JosiahMendes/Autonomous-Rover/Vision/readme.md

## Organisation of Files

Folder DE10_LITE_D8M_VIP_16 contains the Quartus Project together with the software that runs on the Nios II Processor. To test the project, open this folder and and open the `.qpf` file.  

`Distance Calc.C` and `DistanceCalcCalibration.m ` show the implementation of the object location calculation algorithm.

`Testbenches` contain Testbenches for some of the individual modules used in the design of the Image Processing Module

`UART` and `SPI Example Comms` Contain attempts and testing files used for implementing communications between the image processor and the ESP32.
