JosiahMendes/Autonomous-Rover/Energy/README.txt

Note for instructor:
-The folder "PV_power_charger" contains the charging algorithm.
-The folder "discharge_algorithm" contains the algorithm used when discharging the battery
-CSV files of charge cycles are found in the "CSV-files" folder
