JosiahMendes/Autonomous-Rover/Driving/Driving_Structure/Driving subpart.docx

Driving subpart

- Input voltage: ≈5V
- Maximum Input Current: ≈0.245A
- Minimum output voltage: 1.384V
- Maximum output voltage: 4.82V
- Minimum Period: 0.941s
- Maximum RPM: 63.7619

Speed Level | RPM | km/h | mph | Voltage(v)
Very fast | 63.76 | 0.8173 | 0.5078 | 4.82
Fast | 51.77 | 0.6636 | 0.4123 | 3.98
Regular | 39.84 | 0.5107 | 0.3173 | 3.14
Slow | 28.30 | 0.3628 | 0.2254 | 2.3
Very Slow | 19.69 | 0.2524 | 0.1568 | 1.46

The relationship between the voltage and the RPM is almost linear.

These 5 levels of moving speed are the options for the user to send, us a command to the rover. They have been made like that in order, to be, as much simplified and user friendly. Additionally, it is more convenient and straightforward as it does not require further knowledge from the user (voltages, RPM).

On the other hand, someone has the option to give as an input a voltage (1.4V-4.82V) or RPM (20-63.76).
