JosiahMendes/Autonomous-Rover/Energy/Figures/1-s2.0-S0038092X16300111-gr12_lrg.jpg

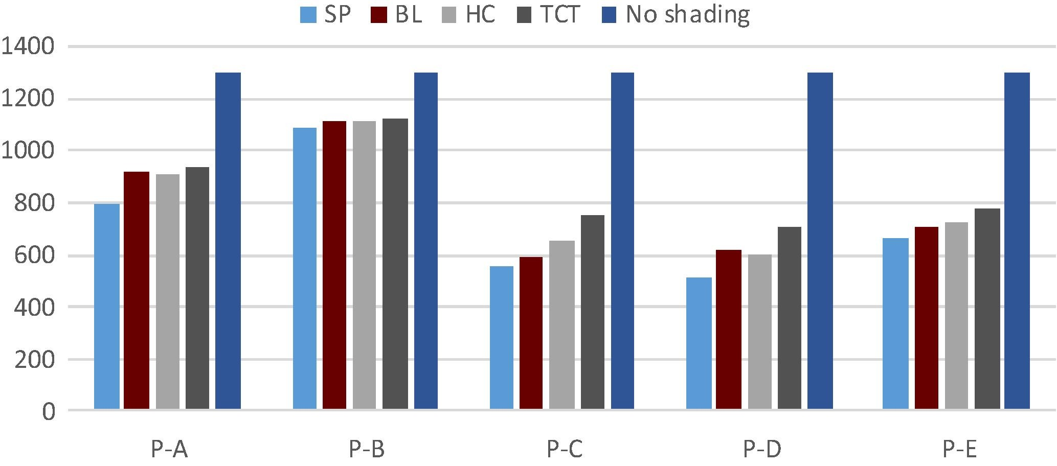
Energy/Figures/1-s2.0-S0038092X16300111-gr12_lrg.jpg
