JosiahMendes/Autonomous-Rover/Energy/Figures/Boost_efficiency.png

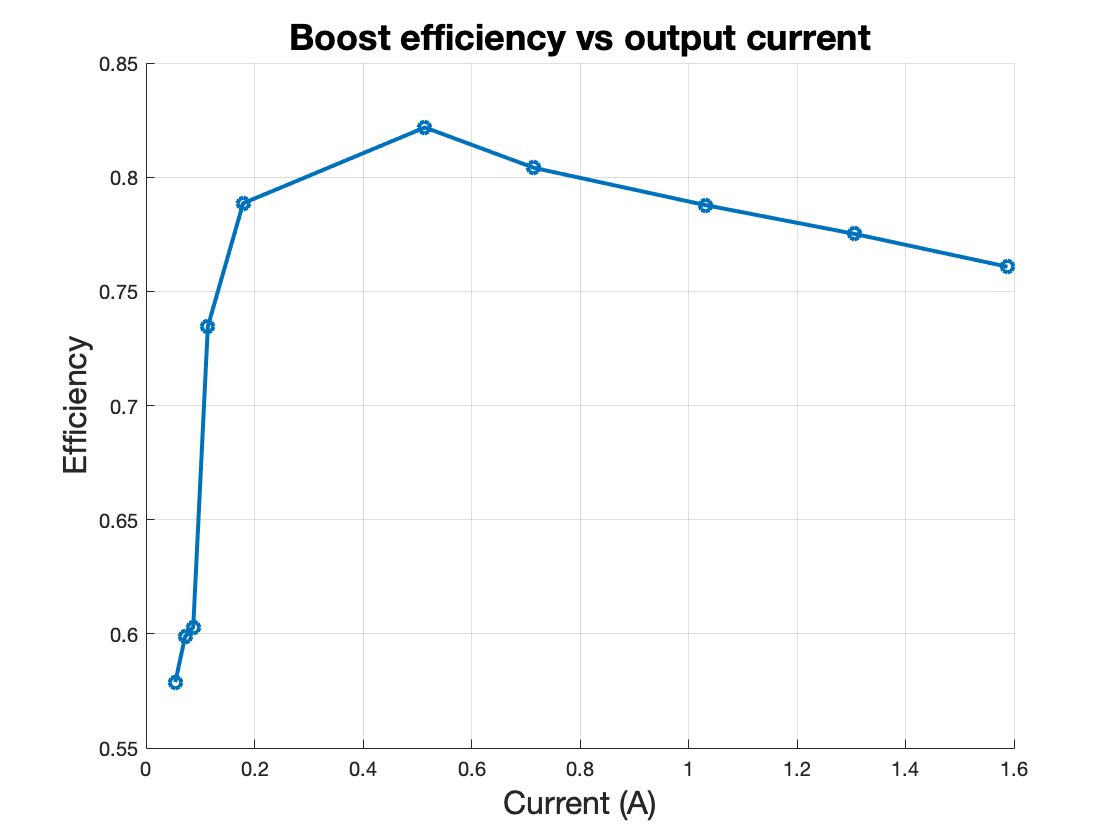
Energy/Figures/Boost_efficiency.png
