JosiahMendes/Autonomous-Rover/Energy/Figures/Circuit_Diagram.png

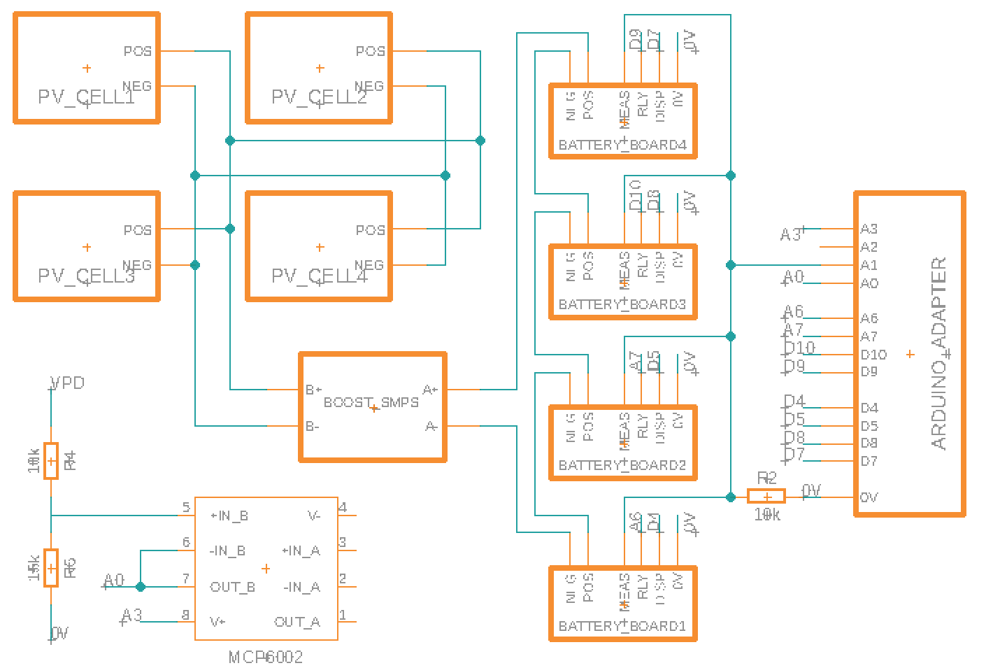
Energy/Figures/Circuit_Diagram.png
