JosiahMendes/Autonomous-Rover/Energy/Skjermbilde 2021-05-26 kl. 19.03.05 1.png

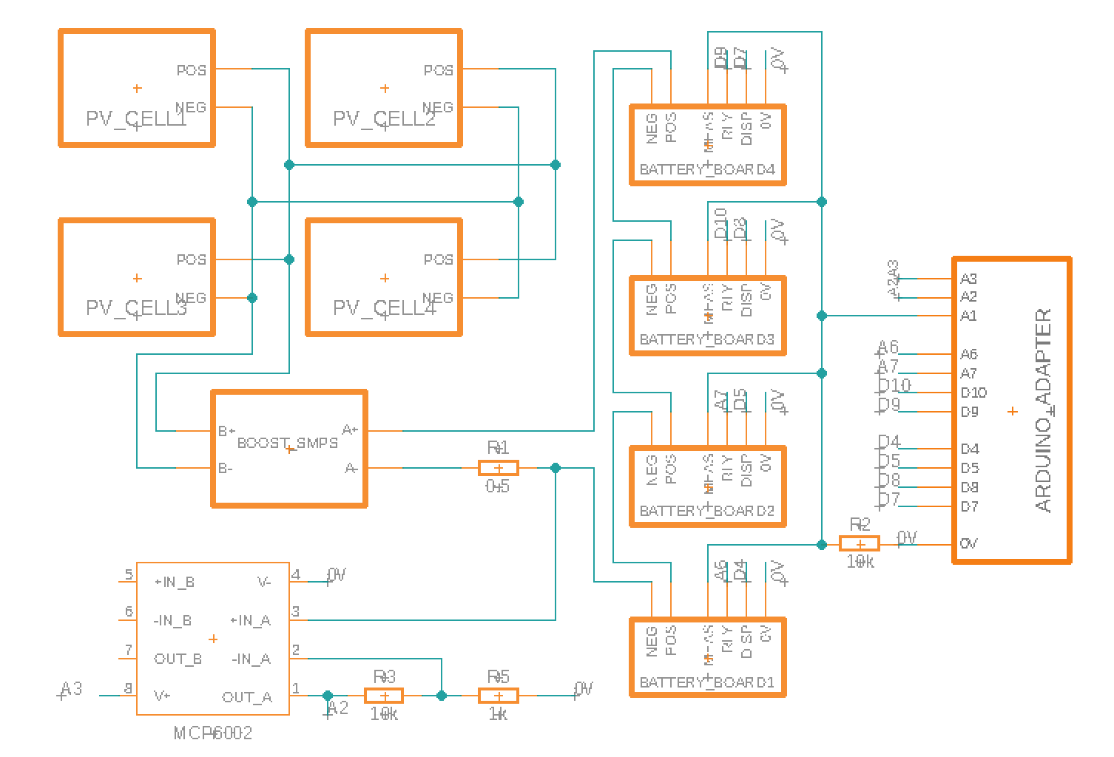
Energy/Skjermbilde 2021-05-26 kl. 19.03.05 1.png
