JosiahMendes/Autonomous-Rover/report/images/ControlFR.png

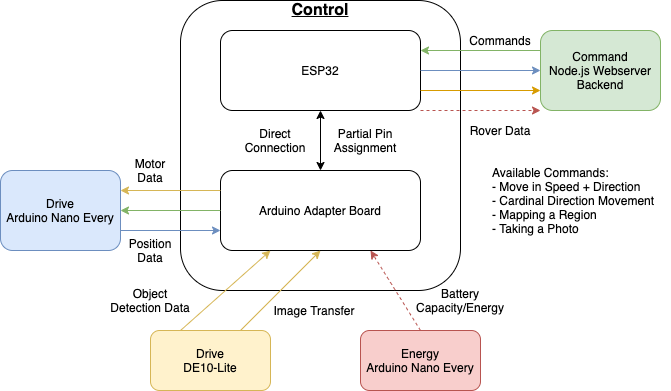
report/images/ControlFR.png
