JosiahMendes/Autonomous-Rover/Integration/TestImages/full_ball_63cm.jpg

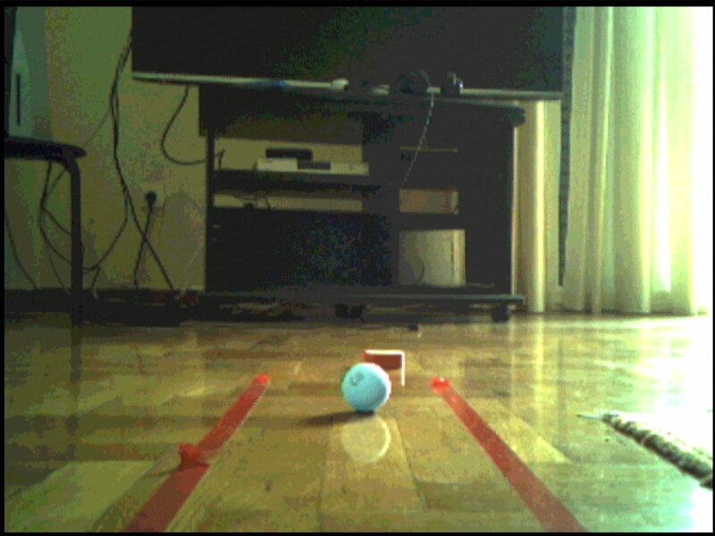
Integration/TestImages/full_ball_63cm.jpg
