JosiahMendes/Autonomous-Rover/report/media/ImageProcessingStream.pdf

### FPGA Device

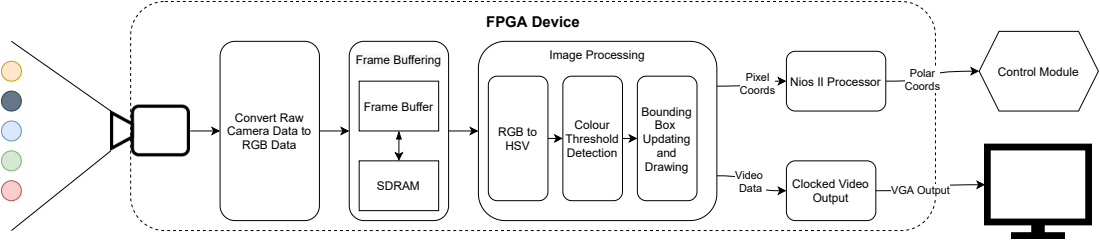
[picture p65: page 1]
Video Data; Pixel Coords; Image Processing; RGB to HSV; Frame Buffering; SDRAM; Frame Buffer; Colour Threshold Detection; Bounding Box Updating and Drawing; Polar; Nios II Processor; Coords; Control Module

Convert Raw
Camera Data to
RGB Data

VGA Output Clocked Video
Output
