JosiahMendes/Autonomous-Rover/report/media/SPI_ImageTransfer.pdf

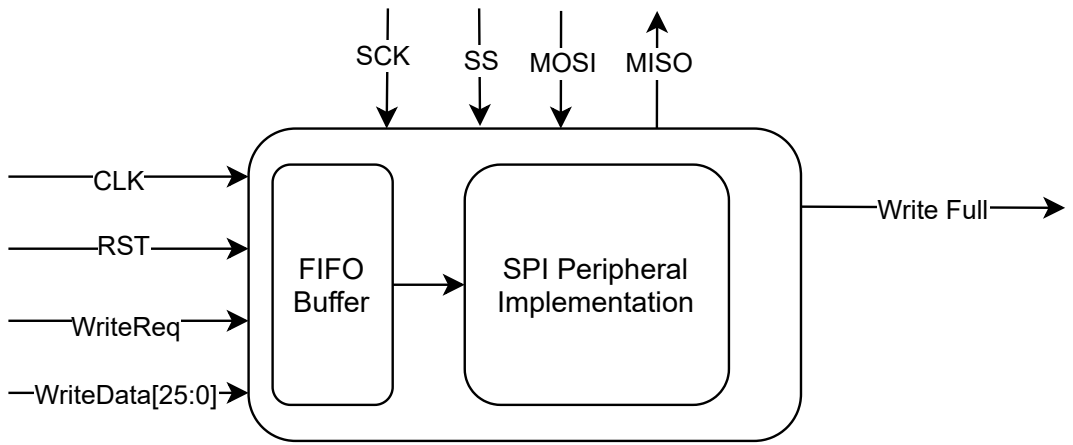
[picture p66: page 1]
CLK; WriteReq; RST; WriteData[25:0]; SCK; MOSI; MISO; Write Full; FIFO Buffer; SPI Peripheral Implementation
