JosiahMendes/Autonomous-Rover/report/media/ControlFunctional.pdf

## Control

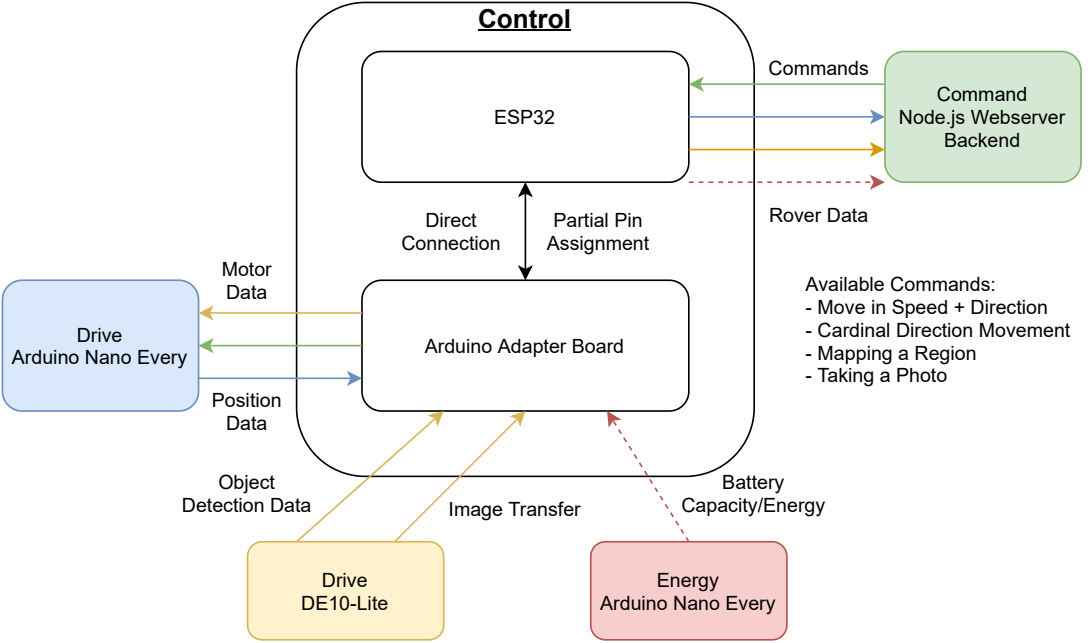
[picture p67: page 1]
ESP32; Partial Pin Assignment; Direct Connection; Object Detection Data; Drive DE10-Lite; Drive; Battery Capacity/Energy; Commands; Motor Data; Position Data; Rover Data; Image Transfer

Command
Node.js Webserver
Backend

Available Commands:
- Move in Speed + Direction
- Cardinal Direction Movement
- Mapping a Region
- Taking a Photo

Arduino Adapter Board

Arduino Nano Every

Energy
