JosiahMendes/Autonomous-Rover/report/media/StructuralDiagram.pdf

Vision | Energy

# MARS Rover Structural Diagram

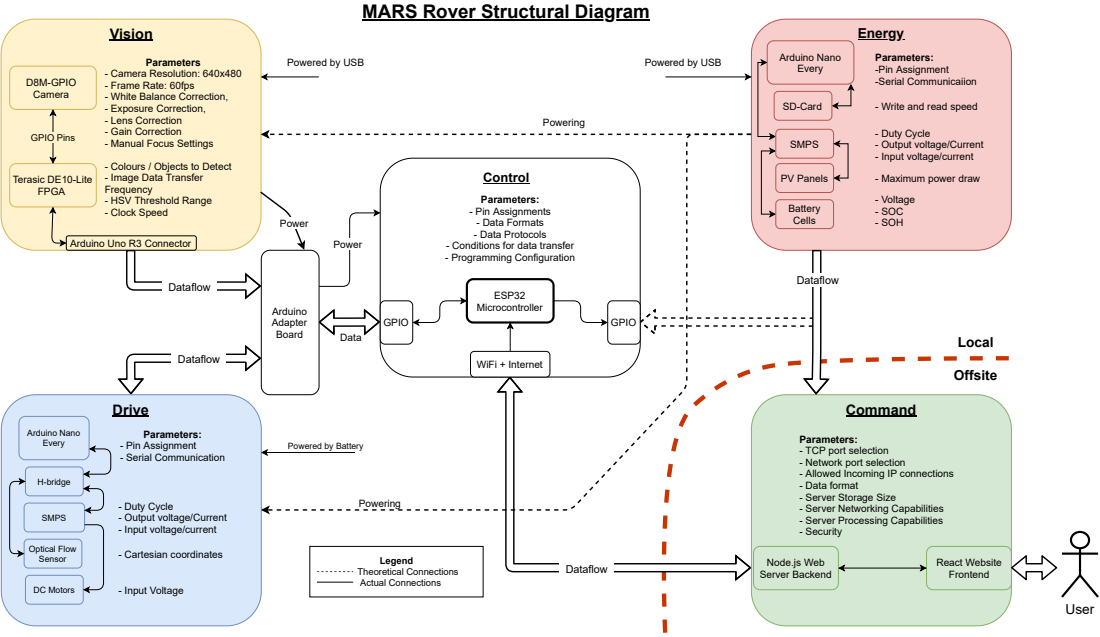
[picture p68: page 1]
ESP32 Microcontroller; Power; Arduino Adapter Board; Arduino Nano Every; SMPS; Battery Cells; PV Panels; D8M-GPIO Camera; Terasic DE10-Lite FPGA; Control; SD-Card; Powering; Powered by USB; GPIO Pins; Dataflow; Parameters: -Pin Assignment -Serial Communicaiion; Parameters; Legend Theoretical Connections Actual Connections; Optical Flow Sensor; DC Motors; Drive; Parameters: - Pin Assignment - Serial Communication; - Cartesian coordinates; - Input Voltage; H-bridge; GPIO; WiFi + Internet; Data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

- Camera Resolution: 640x480
- Frame Rate: 60fps
- White Balance Correction,
- Exposure Correction,
- Lens Correction
- Gain Correction
- Manual Focus Settings

- Write and read speed

- Duty Cycle
- Output voltage/Current
- Input voltage/current

- Colours / Objects to Detect
- Image Data Transfer
Frequency
- HSV Threshold Range
- Clock Speed

- Maximum power draw
- Voltage
- SOC
- SOH

Parameters:
- Pin Assignments
- Data Formats
- Data Protocols
- Conditions for data transfer
- Programming Configuration

Arduino Uno R3 Connector

- TCP port selection
- Network port selection
- Allowed Incoming IP connections
- Data format
- Server Storage Size
- Server Networking Capabilities
- Server Processing Capabilities
- Security

Powered by Battery

Node.js Web
Server Backend
