JosiahMendes/Autonomous-Rover/report/media/ControlFlowChart.pdf

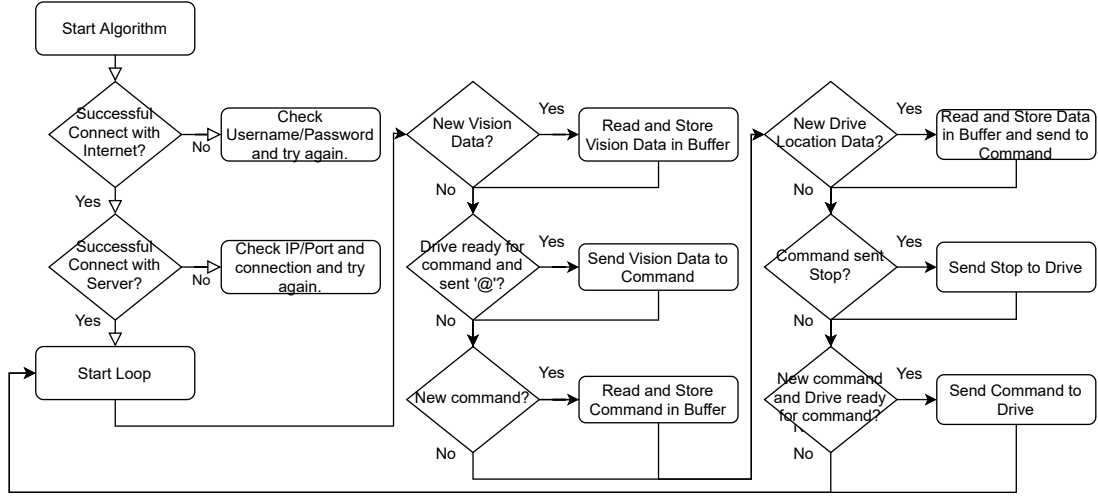
[picture p69: page 1]
Start Algorithm; Successful Connect with Internet?; Check Username/Password; Successful Connect with; Server?; Start Loop; New Vision Data?; New Drive Location Data?; Command sent Stop?; New command?; Yes; New command

Yes
Read and Store Data
in Buffer and send to
Command

Read and Store
Vision Data in Buffer

and try again.

Check IP/Port and
connection and try
again.

Drive ready for
command and
sent '@'?

Send Vision Data to

Send Stop to Drive

Command in Buffer

and Drive ready
for command?

Send Command to
Drive
