JosiahMendes/Autonomous-Rover/report/media/image3.pdf

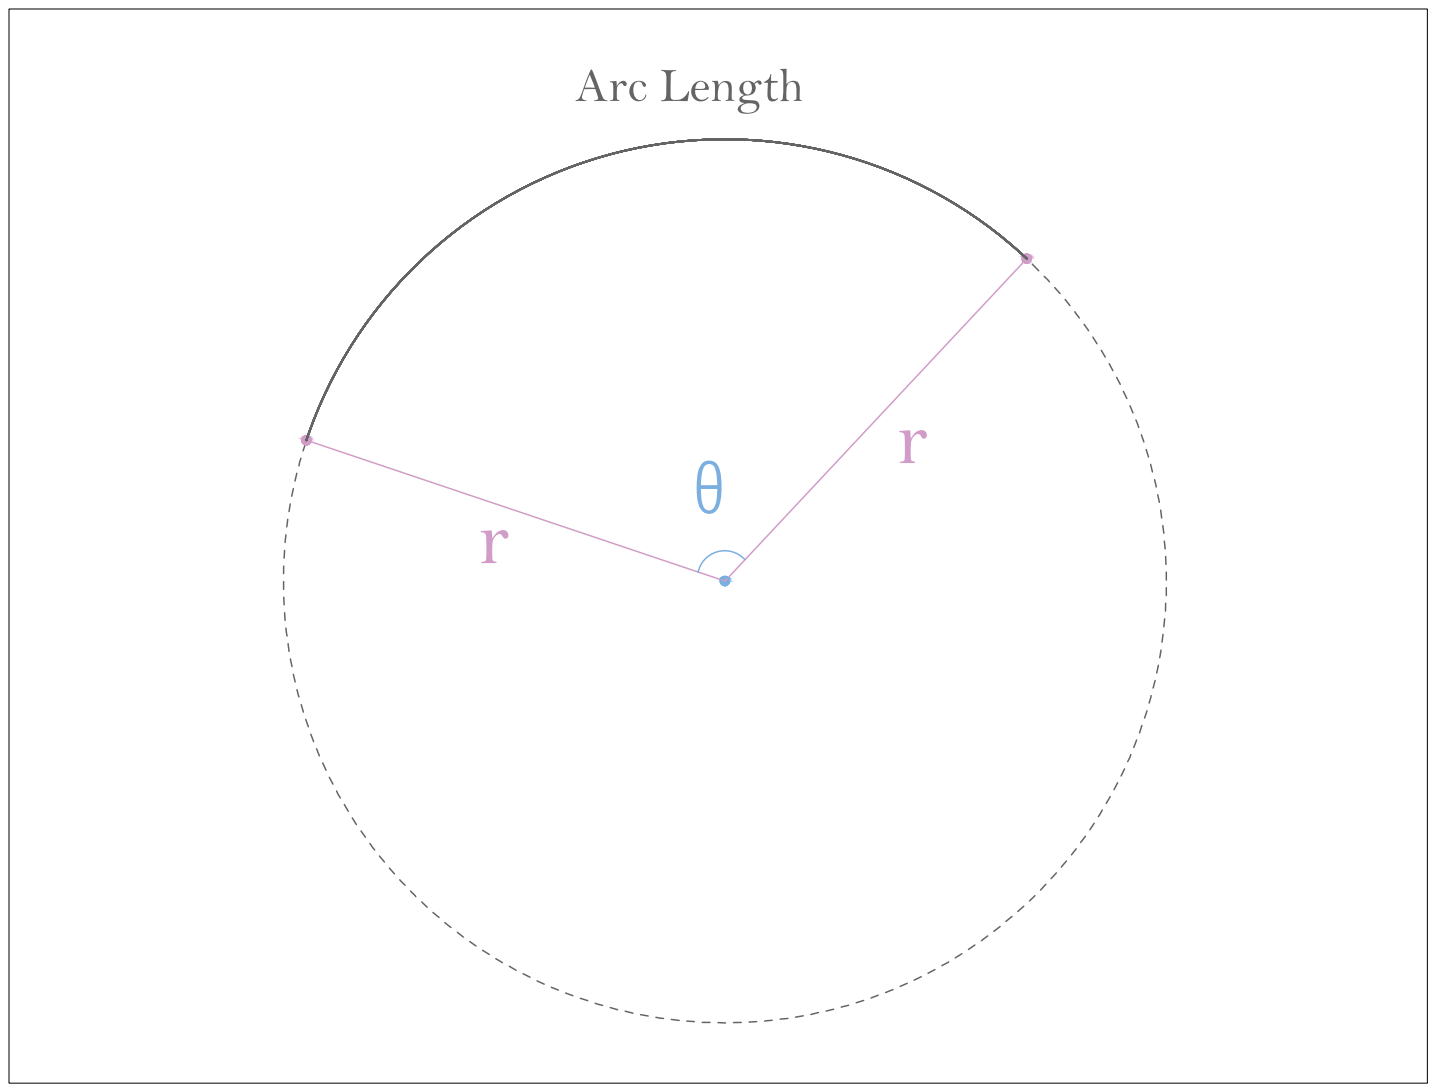
[picture p70: page 1]
