JosiahMendes/Autonomous-Rover/Energy/current_sensor/current_sensor.ino

/*
 * Program written by Yue Zhu (yue.zhu18@imperial.ac.uk) in July 2020.
 * pin6 is PWM output at 62.5kHz.
 * duty-cycle saturation is set as 2% - 98%
 * Control frequency is set as 1.25kHz. 
*/

//Include relevant libraries
#include <Wire.h>
#include <INA219_WE.h>
#include <SPI.h>
#include <SD.h>

INA219_WE ina219; // this is the instantiation of the library for the current sensor

// set up variables using the SD utility library functions:
Sd2Card card;
SdVolume volume;
SdFile root;

const int chipSelect = 10;
float open_loop = 0, closed_loop; // Duty Cycles
float vpd,vb,vref,iL,dutyref,current_mA; // Measurement Variables
unsigned int sensorValue0,sensorValue1,sensorValue2,sensorValue3;  // ADC sample values declaration
float ev=0,cv=0,ei=0,oc=0; //internal signals
float Ts=0.0008; //1.25 kHz control frequency. It's better to design the control period as integral multiple of switching period.
float kpv=0.05024,kiv=15.78,kdv=0; // voltage pid.
float u0v,u1v,delta_uv,e0v,e1v,e2v; // u->output; e->error; 0->this time; 1->last time; 2->last last time
float kpi=0.02512,kii=39.4,kdi=0; // current pid.
float u0i,u1i,delta_ui,e0i,e1i,e2i; // Internal values for the current controller
float uv_max=4, uv_min=0; //anti-windup limitation
float ui_max=1, ui_min=0; //anti-windup limitation
float current_limit = 1.0;
boolean Boost_mode = 0;
boolean CL_mode = 0;
float v05;
int int_count = 0;
String dataString;


unsigned int loopTrigger;
unsigned int com_count=0;   // a variables to count the interrupts. Used for program debugging.

void setup() {

  //5V supply for op-amp
  pinMode(17, OUTPUT);
  digitalWrite(17,true);
  
  
  //Basic pin setups
  noInterrupts(); //disable all interrupts
  pinMode(13, OUTPUT);  //Pin13 is used to time the loops of the controller
  pinMode(3, INPUT_PULLUP); //Pin3 is the input from the Buck/Boost switch
  pinMode(2, INPUT_PULLUP); // Pin 2 is the input from the CL/OL switch
  analogReference(EXTERNAL); // We are using an external analogue reference for the ADC

  // TimerA0 initialization for control-loop interrupt.
  
  TCA0.SINGLE.PER = 999; //
  TCA0.SINGLE.CMP1 = 999; //
  TCA0.SINGLE.CTRLA = TCA_SINGLE_CLKSEL_DIV16_gc | TCA_SINGLE_ENABLE_bm; //16 prescaler, 1M.
  TCA0.SINGLE.INTCTRL = TCA_SINGLE_CMP1_bm; 

  // TimerB0 initialization for PWM output
  
  pinMode(6, OUTPUT);
  TCB0.CTRLA=TCB_CLKSEL_CLKDIV1_gc | TCB_ENABLE_bm; //62.5kHz
  analogWrite(6,120); 

  


  interrupts();  //enable interrupts.
  Wire.begin(); // We need this for the i2c comms for the current sensor
  ina219.init(); // this initiates the current sensor
  Wire.setClock(700000); // set the comms speed for i2c
  Serial.begin(9600); // USB Communications


  
  //Check for the SD Card
  Serial.println("\nInitializing SD card...");
  if (!SD.begin(chipSelect)) {
    Serial.println("* is a card inserted?");
    while (true) {} //It will stick here FOREVER if no SD is in on boot
  } else {
    Serial.println("Wiring is correct and a card is present.");
  }

  if (SD.exists("CurrentS.csv")) { // Wipe the datalog when starting
    SD.remove("CurrentS.csv");
  }
  
}

 void loop() {
  if(loopTrigger) { // This loop is triggered, it wont run unless there is an interrupt
    
    digitalWrite(13, HIGH);   // set pin 13. Pin13 shows the time consumed by each control cycle. It's used for debugging.
    
    // Sample all of the measurements and check which control mode we are in
    sampling();
    CL_mode = digitalRead(3); // input from the OL_CL switch
    Boost_mode = digitalRead(2); // input from the Buck_Boost switch
    int_count++;

    //Serial.println(String(open_loop)+","+String(int_count)); // send it to serial as well in case a computer is connected

    if(int_count == 1000){
      
      if(open_loop < 0.99){
        open_loop += 0.01;

        //Data logging
        dataString = String(vb) + "," + String(1000*v05) + "," + String(current_mA) + "," + String(open_loop); //build a datastring for the CSV file
        Serial.println(dataString); // send it to serial as well in case a computer is connected
        File dataFile = SD.open("CurrentS.csv", FILE_WRITE); // open our CSV file
        if (dataFile){ //If we succeeded (usually this fails if the SD card is out)
          dataFile.println(dataString); // print the data
        } else {
          Serial.println("File not open"); //otherwise print an error
        }
        dataFile.close(); // close the file
        
      }

    int_count = 0;
      
    }


    pwm_modulate(open_loop); // and send it out
 

    digitalWrite(13, LOW);   // reset pin13.
    loopTrigger = 0;
  }
}


// Timer A CMP1 interrupt. Every 800us the program enters this interrupt. 
// This, clears the incoming interrupt flag and triggers the main loop.

ISR(TCA0_CMP1_vect){
  TCA0.SINGLE.INTFLAGS |= TCA_SINGLE_CMP1_bm; //clear interrupt flag
  loopTrigger = 1;
}

// This subroutine processes all of the analogue samples, creating the required values for the main loop

void sampling(){

  // Make the initial sampling operations for the circuit measurements
  
  sensorValue0 = analogRead(A0); //sample Vb
  sensorValue2 = analogRead(A2); //sample Vref
  sensorValue3 = analogRead(A3); //sample Vpd
  current_mA = ina219.getCurrent_mA(); // sample the inductor current (via the sensor chip)

  // Process the values so they are a bit more usable/readable
  // The analogRead process gives a value between 0 and 1023 
  // representing a voltage between 0 and the analogue reference which is 4.096V
  
  vb = sensorValue0 * (4.096 / 1023.0); // Convert the Vb sensor reading to volts
  v05 = sensorValue2 * (4.096 / 1023.0); // Convert the Vref sensor reading to volts
  vpd = sensorValue3 * (4.096 / 1023.0); // Convert the Vpd sensor reading to volts

  // The inductor current is in mA from the sensor so we need to convert to amps.
  // We want to treat it as an input current in the Boost, so its also inverted
  // For open loop control the duty cycle reference is calculated from the sensor
  // differently from the Vref, this time scaled between zero and 1.
  // The boost duty cycle needs to be saturated with a 0.33 minimum to prevent high output voltages
  
  if (Boost_mode == 1){
    iL = -current_mA/1000.0;
    dutyref = saturation(sensorValue2 * (1.0 / 1023.0),0.99,0.33);
  }else{
    iL = current_mA/1000.0;
    dutyref = sensorValue2 * (1.0 / 1023.0);
  }
  
}

float saturation( float sat_input, float uplim, float lowlim){ // Saturatio function
  if (sat_input > uplim) sat_input=uplim;
  else if (sat_input < lowlim ) sat_input=lowlim;
  else;
  return sat_input;
}

void pwm_modulate(float pwm_input){ // PWM function
  analogWrite(6, (int)(255 - pwm_input * 255)); // write it out (inverting for the Buck here)
}
/*end of the program.*/
