JosiahMendes/Autonomous-Rover/Vision/DE10_LITE_D8M_VIP_16/Qsys/synthesis/Qsys.v

// Qsys.v

// Generated using ACDS version 16.1 196

`timescale 1 ps / 1 ps
module Qsys (
		input  wire        alt_vip_itc_0_clocked_video_vid_clk,       //      alt_vip_itc_0_clocked_video.vid_clk
		output wire [23:0] alt_vip_itc_0_clocked_video_vid_data,      //                                 .vid_data
		output wire        alt_vip_itc_0_clocked_video_underflow,     //                                 .underflow
		output wire        alt_vip_itc_0_clocked_video_vid_datavalid, //                                 .vid_datavalid
		output wire        alt_vip_itc_0_clocked_video_vid_v_sync,    //                                 .vid_v_sync
		output wire        alt_vip_itc_0_clocked_video_vid_h_sync,    //                                 .vid_h_sync
		output wire        alt_vip_itc_0_clocked_video_vid_f,         //                                 .vid_f
		output wire        alt_vip_itc_0_clocked_video_vid_h,         //                                 .vid_h
		output wire        alt_vip_itc_0_clocked_video_vid_v,         //                                 .vid_v
		input  wire        altpll_0_areset_conduit_export,            //          altpll_0_areset_conduit.export
		output wire        altpll_0_locked_conduit_export,            //          altpll_0_locked_conduit.export
		input  wire        clk_clk,                                   //                              clk.clk
		output wire        clk_sdram_clk,                             //                        clk_sdram.clk
		output wire        clk_vga_clk,                               //                          clk_vga.clk
		output wire        d8m_xclkin_clk,                            //                       d8m_xclkin.clk
		input  wire        eee_imgproc_0_conduit_mode_new_signal,     //       eee_imgproc_0_conduit_mode.new_signal
		inout  wire        i2c_opencores_camera_export_scl_pad_io,    //      i2c_opencores_camera_export.scl_pad_io
		inout  wire        i2c_opencores_camera_export_sda_pad_io,    //                                 .sda_pad_io
		inout  wire        i2c_opencores_mipi_export_scl_pad_io,      //        i2c_opencores_mipi_export.scl_pad_io
		inout  wire        i2c_opencores_mipi_export_sda_pad_io,      //                                 .sda_pad_io
		input  wire [1:0]  key_external_connection_export,            //          key_external_connection.export
		output wire [9:0]  led_external_connection_export,            //          led_external_connection.export
		output wire        mipi_pwdn_n_external_connection_export,    //  mipi_pwdn_n_external_connection.export
		output wire        mipi_reset_n_external_connection_export,   // mipi_reset_n_external_connection.export
		input  wire        reset_reset_n,                             //                            reset.reset_n
		output wire [12:0] sdram_wire_addr,                           //                       sdram_wire.addr
		output wire [1:0]  sdram_wire_ba,                             //                                 .ba
		output wire        sdram_wire_cas_n,                          //                                 .cas_n
		output wire        sdram_wire_cke,                            //                                 .cke
		output wire        sdram_wire_cs_n,                           //                                 .cs_n
		inout  wire [15:0] sdram_wire_dq,                             //                                 .dq
		output wire [1:0]  sdram_wire_dqm,                            //                                 .dqm
		output wire        sdram_wire_ras_n,                          //                                 .ras_n
		output wire        sdram_wire_we_n,                           //                                 .we_n
		input  wire [9:0]  sw_external_connection_export,             //           sw_external_connection.export
		inout  wire        terasic_auto_focus_0_conduit_vcm_i2c_sda,  //     terasic_auto_focus_0_conduit.vcm_i2c_sda
		input  wire        terasic_auto_focus_0_conduit_clk50,        //                                 .clk50
		inout  wire        terasic_auto_focus_0_conduit_vcm_i2c_scl,  //                                 .vcm_i2c_scl
		input  wire [11:0] terasic_camera_0_conduit_end_D,            //     terasic_camera_0_conduit_end.D
		input  wire        terasic_camera_0_conduit_end_FVAL,         //                                 .FVAL
		input  wire        terasic_camera_0_conduit_end_LVAL,         //                                 .LVAL
		input  wire        terasic_camera_0_conduit_end_PIXCLK,       //                                 .PIXCLK
		input  wire        uart_0_external_connection_rxd,            //       uart_0_external_connection.rxd
		output wire        uart_0_external_connection_txd             //                                 .txd
	);

	wire         terasic_camera_0_avalon_streaming_source_valid;                                   // TERASIC_CAMERA_0:st_valid -> alt_vip_vfb_0:din_valid
	wire  [23:0] terasic_camera_0_avalon_streaming_source_data;                                    // TERASIC_CAMERA_0:st_data -> alt_vip_vfb_0:din_data
	wire         terasic_camera_0_avalon_streaming_source_ready;                                   // alt_vip_vfb_0:din_ready -> TERASIC_CAMERA_0:st_ready
	wire         terasic_camera_0_avalon_streaming_source_startofpacket;                           // TERASIC_CAMERA_0:st_sop -> alt_vip_vfb_0:din_startofpacket
	wire         terasic_camera_0_avalon_streaming_source_endofpacket;                             // TERASIC_CAMERA_0:st_eop -> alt_vip_vfb_0:din_endofpacket
	wire         eee_imgproc_0_avalon_streaming_source_valid;                                      // EEE_IMGPROC_0:source_valid -> alt_vip_itc_0:is_valid
	wire  [23:0] eee_imgproc_0_avalon_streaming_source_data;                                       // EEE_IMGPROC_0:source_data -> alt_vip_itc_0:is_data
	wire         eee_imgproc_0_avalon_streaming_source_ready;                                      // alt_vip_itc_0:is_ready -> EEE_IMGPROC_0:source_ready
	wire         eee_imgproc_0_avalon_streaming_source_startofpacket;                              // EEE_IMGPROC_0:source_sop -> alt_vip_itc_0:is_sop
	wire         eee_imgproc_0_avalon_streaming_source_endofpacket;                                // EEE_IMGPROC_0:source_eop -> alt_vip_itc_0:is_eop
	wire         terasic_auto_focus_0_dout_valid;                                                  // TERASIC_AUTO_FOCUS_0:source_valid -> EEE_IMGPROC_0:sink_valid
	wire  [23:0] terasic_auto_focus_0_dout_data;                                                   // TERASIC_AUTO_FOCUS_0:source_data -> EEE_IMGPROC_0:sink_data
	wire         terasic_auto_focus_0_dout_ready;                                                  // EEE_IMGPROC_0:sink_ready -> TERASIC_AUTO_FOCUS_0:source_ready
	wire         terasic_auto_focus_0_dout_startofpacket;                                          // TERASIC_AUTO_FOCUS_0:source_sop -> EEE_IMGPROC_0:sink_sop
	wire         terasic_auto_focus_0_dout_endofpacket;                                            // TERASIC_AUTO_FOCUS_0:source_eop -> EEE_IMGPROC_0:sink_eop
	wire         alt_vip_vfb_0_dout_valid;                                                         // alt_vip_vfb_0:dout_valid -> TERASIC_AUTO_FOCUS_0:sink_valid
	wire  [23:0] alt_vip_vfb_0_dout_data;                                                          // alt_vip_vfb_0:dout_data -> TERASIC_AUTO_FOCUS_0:sink_data
	wire         alt_vip_vfb_0_dout_ready;                                                         // TERASIC_AUTO_FOCUS_0:sink_ready -> alt_vip_vfb_0:dout_ready
	wire         alt_vip_vfb_0_dout_startofpacket;                                                 // alt_vip_vfb_0:dout_startofpacket -> TERASIC_AUTO_FOCUS_0:sink_sop
	wire         alt_vip_vfb_0_dout_endofpacket;                                                   // alt_vip_vfb_0:dout_endofpacket -> TERASIC_AUTO_FOCUS_0:sink_eop
	wire         altpll_0_c2_clk;                                                                  // altpll_0:c2 -> [EEE_IMGPROC_0:clk, TERASIC_AUTO_FOCUS_0:clk, TERASIC_CAMERA_0:clk, alt_vip_itc_0:is_clk, alt_vip_vfb_0:clock, mm_interconnect_0:altpll_0_c2_clk, mm_interconnect_1:altpll_0_c2_clk, rst_controller:clk, sdram:clk]
	wire         nios2_gen2_custom_instruction_master_readra;                                      // nios2_gen2:E_ci_combo_readra -> nios2_gen2_custom_instruction_master_translator:ci_slave_readra
	wire         nios2_gen2_custom_instruction_master_readrb;                                      // nios2_gen2:E_ci_combo_readrb -> nios2_gen2_custom_instruction_master_translator:ci_slave_readrb
	wire   [4:0] nios2_gen2_custom_instruction_master_multi_b;                                     // nios2_gen2:A_ci_multi_b -> nios2_gen2_custom_instruction_master_translator:ci_slave_multi_b
	wire   [4:0] nios2_gen2_custom_instruction_master_multi_c;                                     // nios2_gen2:A_ci_multi_c -> nios2_gen2_custom_instruction_master_translator:ci_slave_multi_c
	wire         nios2_gen2_custom_instruction_master_reset_req;                                   // nios2_gen2:A_ci_multi_reset_req -> nios2_gen2_custom_instruction_master_translator:ci_slave_multi_reset_req
	wire   [4:0] nios2_gen2_custom_instruction_master_multi_a;                                     // nios2_gen2:A_ci_multi_a -> nios2_gen2_custom_instruction_master_translator:ci_slave_multi_a
	wire  [31:0] nios2_gen2_custom_instruction_master_result;                                      // nios2_gen2_custom_instruction_master_translator:ci_slave_result -> nios2_gen2:E_ci_combo_result
	wire  [31:0] nios2_gen2_custom_instruction_master_datab;                                       // nios2_gen2:E_ci_combo_datab -> nios2_gen2_custom_instruction_master_translator:ci_slave_datab
	wire  [31:0] nios2_gen2_custom_instruction_master_dataa;                                       // nios2_gen2:E_ci_combo_dataa -> nios2_gen2_custom_instruction_master_translator:ci_slave_dataa
	wire         nios2_gen2_custom_instruction_master_writerc;                                     // nios2_gen2:E_ci_combo_writerc -> nios2_gen2_custom_instruction_master_translator:ci_slave_writerc
	wire  [31:0] nios2_gen2_custom_instruction_master_multi_dataa;                                 // nios2_gen2:A_ci_multi_dataa -> nios2_gen2_custom_instruction_master_translator:ci_slave_multi_dataa
	wire         nios2_gen2_custom_instruction_master_multi_writerc;                               // nios2_gen2:A_ci_multi_writerc -> nios2_gen2_custom_instruction_master_translator:ci_slave_multi_writerc
	wire   [4:0] nios2_gen2_custom_instruction_master_a;                                           // nios2_gen2:E_ci_combo_a -> nios2_gen2_custom_instruction_master_translator:ci_slave_a
	wire   [4:0] nios2_gen2_custom_instruction_master_b;                                           // nios2_gen2:E_ci_combo_b -> nios2_gen2_custom_instruction_master_translator:ci_slave_b
	wire  [31:0] nios2_gen2_custom_instruction_master_multi_result;                                // nios2_gen2_custom_instruction_master_translator:ci_slave_multi_result -> nios2_gen2:A_ci_multi_result
	wire         nios2_gen2_custom_instruction_master_clk;                                         // nios2_gen2:A_ci_multi_clock -> nios2_gen2_custom_instruction_master_translator:ci_slave_multi_clk
	wire  [31:0] nios2_gen2_custom_instruction_master_multi_datab;                                 // nios2_gen2:A_ci_multi_datab -> nios2_gen2_custom_instruction_master_translator:ci_slave_multi_datab
	wire   [4:0] nios2_gen2_custom_instruction_master_c;                                           // nios2_gen2:E_ci_combo_c -> nios2_gen2_custom_instruction_master_translator:ci_slave_c
	wire  [31:0] nios2_gen2_custom_instruction_master_ipending;                                    // nios2_gen2:E_ci_combo_ipending -> nios2_gen2_custom_instruction_master_translator:ci_slave_ipending
	wire         nios2_gen2_custom_instruction_master_start;                                       // nios2_gen2:A_ci_multi_start -> nios2_gen2_custom_instruction_master_translator:ci_slave_multi_start
	wire         nios2_gen2_custom_instruction_master_done;                                        // nios2_gen2_custom_instruction_master_translator:ci_slave_multi_done -> nios2_gen2:A_ci_multi_done
	wire   [7:0] nios2_gen2_custom_instruction_master_n;                                           // nios2_gen2:E_ci_combo_n -> nios2_gen2_custom_instruction_master_translator:ci_slave_n
	wire         nios2_gen2_custom_instruction_master_estatus;                                     // nios2_gen2:E_ci_combo_estatus -> nios2_gen2_custom_instruction_master_translator:ci_slave_estatus
	wire         nios2_gen2_custom_instruction_master_clk_en;                                      // nios2_gen2:A_ci_multi_clk_en -> nios2_gen2_custom_instruction_master_translator:ci_slave_multi_clken
	wire         nios2_gen2_custom_instruction_master_reset;                                       // nios2_gen2:A_ci_multi_reset -> nios2_gen2_custom_instruction_master_translator:ci_slave_multi_reset
	wire         nios2_gen2_custom_instruction_master_multi_readrb;                                // nios2_gen2:A_ci_multi_readrb -> nios2_gen2_custom_instruction_master_translator:ci_slave_multi_readrb
	wire         nios2_gen2_custom_instruction_master_multi_readra;                                // nios2_gen2:A_ci_multi_readra -> nios2_gen2_custom_instruction_master_translator:ci_slave_multi_readra
	wire   [7:0] nios2_gen2_custom_instruction_master_multi_n;                                     // nios2_gen2:A_ci_multi_n -> nios2_gen2_custom_instruction_master_translator:ci_slave_multi_n
	wire  [31:0] nios2_gen2_custom_instruction_master_translator_comb_ci_master_result;            // nios2_gen2_custom_instruction_master_comb_xconnect:ci_slave_result -> nios2_gen2_custom_instruction_master_translator:comb_ci_master_result
	wire         nios2_gen2_custom_instruction_master_translator_comb_ci_master_readra;            // nios2_gen2_custom_instruction_master_translator:comb_ci_master_readra -> nios2_gen2_custom_instruction_master_comb_xconnect:ci_slave_readra
	wire   [4:0] nios2_gen2_custom_instruction_master_translator_comb_ci_master_a;                 // nios2_gen2_custom_instruction_master_translator:comb_ci_master_a -> nios2_gen2_custom_instruction_master_comb_xconnect:ci_slave_a
	wire   [4:0] nios2_gen2_custom_instruction_master_translator_comb_ci_master_b;                 // nios2_gen2_custom_instruction_master_translator:comb_ci_master_b -> nios2_gen2_custom_instruction_master_comb_xconnect:ci_slave_b
	wire         nios2_gen2_custom_instruction_master_translator_comb_ci_master_readrb;            // nios2_gen2_custom_instruction_master_translator:comb_ci_master_readrb -> nios2_gen2_custom_instruction_master_comb_xconnect:ci_slave_readrb
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
	wire         nios2_gen2_custom_instruction_master_comb_xconnect_ci_master0_writerc;            // nios2_gen2_custom_instruction_master_comb_xconnect:ci_master0_writerc -> nios2_gen2_custom_instruction_master_comb_slave_translator0:ci_slave_writerc
	wire   [7:0] nios2_gen2_custom_instruction_master_comb_xconnect_ci_master0_n;                  // nios2_gen2_custom_instruction_master_comb_xconnect:ci_master0_n -> nios2_gen2_custom_instruction_master_comb_slave_translator0:ci_slave_n
	wire  [31:0] nios2_gen2_custom_instruction_master_comb_slave_translator0_ci_master_result;     // nios_custom_instr_floating_point_2_0:s1_result -> nios2_gen2_custom_instruction_master_comb_slave_translator0:ci_master_result
	wire  [31:0] nios2_gen2_custom_instruction_master_comb_slave_translator0_ci_master_datab;      // nios2_gen2_custom_instruction_master_comb_slave_translator0:ci_master_datab -> nios_custom_instr_floating_point_2_0:s1_datab
	wire  [31:0] nios2_gen2_custom_instruction_master_comb_slave_translator0_ci_master_dataa;      // nios2_gen2_custom_instruction_master_comb_slave_translator0:ci_master_dataa -> nios_custom_instr_floating_point_2_0:s1_dataa
	wire   [3:0] nios2_gen2_custom_instruction_master_comb_slave_translator0_ci_master_n;          // nios2_gen2_custom_instruction_master_comb_slave_translator0:ci_master_n -> nios_custom_instr_floating_point_2_0:s1_n
	wire         nios2_gen2_custom_instruction_master_translator_multi_ci_master_readra;           // nios2_gen2_custom_instruction_master_translator:multi_ci_master_readra -> nios2_gen2_custom_instruction_master_multi_xconnect:ci_slave_readra
	wire   [4:0] nios2_gen2_custom_instruction_master_translator_multi_ci_master_a;                // nios2_gen2_custom_instruction_master_translator:multi_ci_master_a -> nios2_gen2_custom_instruction_master_multi_xconnect:ci_slave_a
	wire   [4:0] nios2_gen2_custom_instruction_master_translator_multi_ci_master_b;                // nios2_gen2_custom_instruction_master_translator:multi_ci_master_b -> nios2_gen2_custom_instruction_master_multi_xconnect:ci_slave_b
	wire         nios2_gen2_custom_instruction_master_translator_multi_ci_master_clk;              // nios2_gen2_custom_instruction_master_translator:multi_ci_master_clk -> nios2_gen2_custom_instruction_master_multi_xconnect:ci_slave_clk
	wire         nios2_gen2_custom_instruction_master_translator_multi_ci_master_readrb;           // nios2_gen2_custom_instruction_master_translator:multi_ci_master_readrb -> nios2_gen2_custom_instruction_master_multi_xconnect:ci_slave_readrb
	wire   [4:0] nios2_gen2_custom_instruction_master_translator_multi_ci_master_c;                // nios2_gen2_custom_instruction_master_translator:multi_ci_master_c -> nios2_gen2_custom_instruction_master_multi_xconnect:ci_slave_c
	wire         nios2_gen2_custom_instruction_master_translator_multi_ci_master_start;            // nios2_gen2_custom_instruction_master_translator:multi_ci_master_start -> nios2_gen2_custom_instruction_master_multi_xconnect:ci_slave_start
	wire         nios2_gen2_custom_instruction_master_translator_multi_ci_master_reset_req;        // nios2_gen2_custom_instruction_master_translator:multi_ci_master_reset_req -> nios2_gen2_custom_instruction_master_multi_xconnect:ci_slave_reset_req
	wire         nios2_gen2_custom_instruction_master_translator_multi_ci_master_done;             // nios2_gen2_custom_instruction_master_multi_xconnect:ci_slave_done -> nios2_gen2_custom_instruction_master_translator:multi_ci_master_done
	wire   [7:0] nios2_gen2_custom_instruction_master_translator_multi_ci_master_n;                // nios2_gen2_custom_instruction_master_translator:multi_ci_master_n -> nios2_gen2_custom_instruction_master_multi_xconnect:ci_slave_n
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
