JosiahMendes/Autonomous-Rover/(commit log)

2021-05-13 Added SOF + ELF Files from Stott's Example
    Use Quartus Programmer to download SOF to device and use Nios2 Command
    Shell to download compiled software - ELF to run on soft core.
2021-05-14 Added two Test Scripts for ESP32
    Requires Arduino IDE, ESP32 board configuration and the required drivers in order to be able to run on the ESP32
2021-05-15 Created figures for the different feasible configurations of the PV panels and started the report
    [Cell1.CSV]
2021-05-17 Updated SOF and ELF with exposure + manual controls
    KEY1 - Located on board, controls crop/zoom, not sure if digital or
    physical
    KEY0 - Located on board, toggles autofocus
    Commands to be entered in nios2-terminal
    'e' & 'd' - increases and decreases exposure respectively
    't' & 'g' - increases and decreases gain (?) respectively
    'r' & 'f' - manual focus increase and decrease respectively`
2021-05-18 react app example with many files deleted to save up space
    [Luke.2.1-Luke.2.20.csv]
2021-05-19 Added CSV files used for characterising the PV-panels
    [Cell1Lamp.CSV, Cell1Test.CSV, Panel1Lamp.CSV, Panel1Lamp2-kopi.CSV, Panel1Lamp2.CSV, Panel2Lamp.CSV, Panel3Lamp.CSV, Panel4Lamp.CSV]
2021-05-20 Added Python Server Code
    This script exists to interface with the ESP32 using a TCP protocol over a port to send messages through the terminal and receive messages from the ESP32. It is mainly a tool for debugging, details are commented on the code.
2021-05-20 Added ESP32 Client Code
    This is Arduino code for the ESP32 which sets it as a station under your router and allows it to act as a client, connecting to a server of your choice and reading any data which may be transmitted through TCP. It will then echo that data back to the server as well as to any Serially connected devices. Details are commented on the code.
2021-05-21 Updated ESP32 Client Code to V1.1
    Added UART connection so that when it receives a command from the Python Server, it will send the data Serially through UART port 0 to any other device connected
2021-05-21 Finished characterising cells and started writing report draft
    [Cell2.CSV, Cell3.CSV, Cell4.CSV, Cell5.CSV, Panel2Lamp.CSV, Panel4Lamp.CSV]
2021-05-21 Updated ESP32 Client Code to V1.2
    Updated UART library to Softserial so that it can serially communicate using TX0 and RX0 with Drive subsystem
2021-05-21 the web server can now tell which button was pressed on the web browser over TCP
2021-05-21 Tested basic UART between driving and control
2021-05-24 Implemented pulse charging, currently working on SOC and SOH algorithms
    [2HzTest.CSV, QuickerTest.CSV]
2021-05-24 Added Vision Quartus Project to Main Project
    IP modules from OpenCores and Qsys are included. Apologies for the large
    amount of files, quite difficult to seperate what is necessaary and what
    is unnecessary as there are literally too many files.
    Current version has SPI implemented at a hardware level, but not at a
    software level (NIOS II is incapable of using it)
2021-05-27 Finished testing PV panels, did test with 0.5 ohm resistor as current sensor
    [CURRENTS.CSV]
2021-05-27 Update rover_navigation.cpp
    The rover can now rotate and move forward, backwards and the voltage controller has the optimal values
2021-05-27 optical flow sensor class
2021-05-27 Updated ESP32 Client Code to V1.3
    Changed UART library back to port definitions using TX2 and RX2 for Drive
2021-05-27 Added ESP32 Code for Drive Debugging V1.0
    Added Arduino code for sending commands through Serial terminal to Drive subsystem whenever the drive subsystem sends an @ as an initialiser
2021-05-27 Working SPI Comms between FPGA and Arduino
    nios2.c is the code that runs on the FPGA, sending a number each time.
    Arduino_slave.ino recieves the number and prints it out as a character.
2021-05-29 Made most of the final charging code, making a commit before doing some risky changes
2021-05-31 added battery and textbox component and connected mongodb database to the backend
2021-06-01 Added Energy Client Code for comms with Command
    Added Python code using a library pyserial (which needs to be pip installed on the machine) to serially connect with the arduino and send the data from the arduino to a server of your choice by inputting an ip and port number
2021-06-02 The speed levels and the power were recalculated with the new controller
2021-06-02 Commit before splitting charging algorithm in 2
2021-06-04 Fixed Inferred Latches in RGB_TO_HSV.sv
    As there was no default value in the combinatorial block, latches were
    being inferred, which triggered a warning about unsafe behaviour in
    Quartus.
    Also changed constant values to add bit width to prevent truncation and
    also clear some warnings in Quartus.
    [EEE_IMGPROC.v, rgb_to_hsv.sv]
2021-06-05 added websocket to enable communication between backend and frontend, and implemented a couple of ways to visualize the map on the web browser
2021-06-06 Making final touches to charging and discharging algorithm
    [BATCHARG.CSV, BATDISCH.CSV, ENERGYLU.CSV, STATEOFH.CSV]
2021-06-06 Added all energy subheadings
    [2HzTest.CSV, BATCHARG.CSV, BATDISCH.CSV, CURRENTS.CSV, Cell1.CSV, Cell1Lamp.CSV, Cell1Test.CSV, Cell2.CSV]
2021-06-07 Finished the PV power charger script and made some figures for report
    [BATCHARG.CSV, BATDISCH.CSV, ENERGYLU.CSV, STATEOFH.CSV]
2021-06-08 I have made a mistake. It is not Pout, it is Pin
2021-06-08 Updated ESP32 Client Code to V2.0
    Incorporated Drive and Command into the code for communication between the two subsystems as well as the framework for Vision as an SPI master
2021-06-09 Test UART Comms
2021-06-09 Added the battery configuration and PV configuration sections
2021-06-10 Calibrated Distance Calculation Algorithm
    Need to make sure that value order from verilog is correct, and also
    redo the calculations so that it takes the middle bottom point, and also
    filter out measurements that are either too large or too small on this
    side as well.
    Changes to be committed:
    new file: Vision/distanceCalc.c
2021-06-11 Added MATLAB script for calibration
2021-06-12 ELF for testing UART
2021-06-12 slower ELF for UART testing
2021-06-12 ELF+SOF for testing UART slow
2021-06-13 Switched Pins around
2021-06-13 Updated ESP32 Client Code to V3.0
    Incorporated Vision and stopping Command for Drive into the communication loop
2021-06-14 Updated ESP32 Client Code to V3.1
    Fixed some mistakes and syntax errors within previous code
    [ControlClient.ino]
2021-06-15 Added Matlab calibration script for distances
2021-06-15 Rewrote a lot of stuff to make it shorter
    [PV_power_charger.ino, discharge_algorithm.ino]
2021-06-15 Vision: Pixel Based Filtering
2021-06-15 Testing: Info about White Balance and Lens Correction
2021-06-15 Control: Adding ESP32 Algorithm Flowchart
2021-06-15 Control: Adding Data Flowchart
2021-06-15 Removed Redundant Files
    [Luke.2.1-Luke.2.20.csv]
