JosiahMendes/Autonomous-Rover/report/images/ESP32_UART.jpg

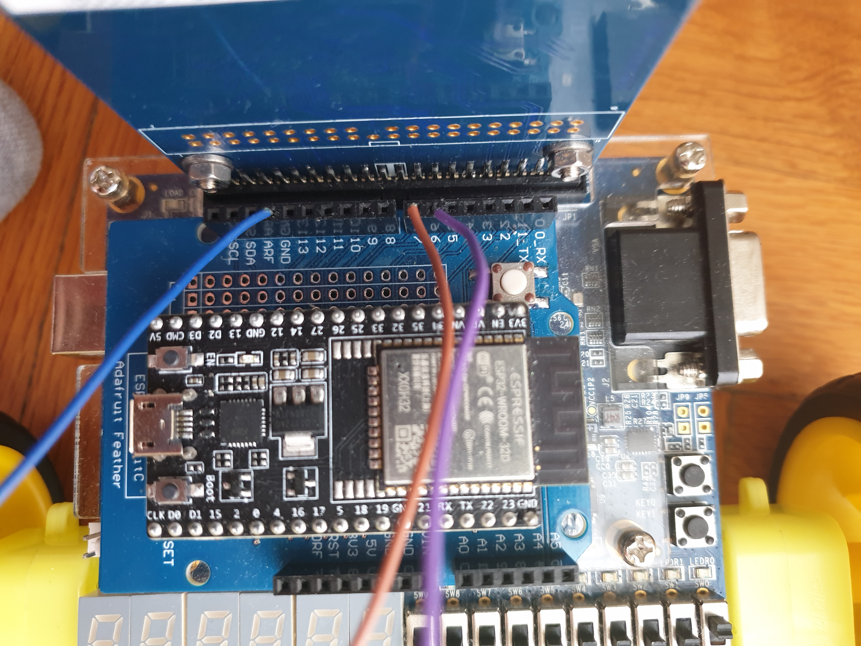
[picture p31: report/images/ESP32_UART.jpg]
report/images/ESP32_UART.jpg
